cruiser0002/laserresin5/export/SM5B_3_ASM_BOM.xlsx

Photonbeam
Item # | Name | Part number | Quantity | Supplier
1 | platform | SM01B | 1 | Metalfx
2 | crane | SM02B | 1 | Metalfx
3 | drawer | SM03B | 1 | Metalfx
4 | drawer_pcb | SM04B | 1 | Metalfx
5 | frame_front | SM05B | 1 | Metalfx
6 | reservoir | SM06B | 2 | Metalfx
7 | foot | SM07B | 1 | Metalfx
8 | frame_back | SM08B | 1 | Metalfx
9 | laserholder | SM09B | 1 | Metalfx
 | tray |  | 1 | Ponoko
 | shield_front |  | 1 | Ponoko
 | shield_side |  | 2 | Ponoko
 | shield_top |  | 1 | Ponoko
Mechanical
Item # | Name | Part # | Quantity | Supplier | Link
1 | ACME 8mm 250mm (pitch = ?) |  | 1 | ebay
2 | LMK8LUU | LMK8LUU | 2 | ebay
3 | SHF8 | SHF8 | 4 | ebay
4 | NEMA17 |  | 1 | ebay
5 | Handles | 91251A106 | 2 | mcmaster | http://www.mcmaster.com/#1568a63/=14mm5we
Mounting hardware
Item # | Name | Part # | Quantity | Supplier | Link
1 | M3 press fit nut | s-m3-0 | 24 | ebay | http://www.ebay.com/itm/200-Pieces-S-M3-0-Steel-Self-Clinching-Nut-Galvanized-/331943960998
2 | M5 press fit nut | s-m5-1 | 8 | ebay | http://www.ebay.com/itm/150-Pieces-S-M5-1-Steel-Self-Clinching-Nut-Galvanized-/232052049197
3 | M3x5 screw | 91239A110 | 12 | mcmaster | http://www.mcmaster.com/#91239a110/=14mmbfn
4 | M3x10 screw | 91239A115 | 57 | mcmaster | http://www.mcmaster.com/#91239a115/=14mmbom
5 | M3 thumb screw | 92552A418 | 1 | mcmaster | http://www.mcmaster.com/#92552a418/=14mmo47
6 | M5x16 screw | 91239A232 | 8 | mcmaster | http://www.mcmaster.com/#91239a232/=14mmc0l
7 | M5 thumb screw | 96016A233 | 8 | mcmaster | http://www.mcmaster.com/#96016a233/=14mmegs
8 | 4-40 screw | 91251A106 | 4 | mcmaster | http://www.mcmaster.com/#91251a106/=14mmd2q
9 | M4x6 screw | 91239A138 | 2 | mcmaster | http://www.mcmaster.com/#91239a138/=14mmfda
10 | Rivet1 | 97517A020 | 60 | mcmaster | http://www.mcmaster.com/#97517a020/=14mm0ah
11 | Rivet2 | 97526A120 | 4 | mcmaster | http://www.mcmaster.com/#97526a120/=14mlyy8
12 | M3 nut | 90591A250 | 44 | mcmaster | http://www.mcmaster.com/#90591a250/=14mmijd
13 | M5 nut | 90591A260 | 8 | mcmaster | http://www.mcmaster.com/#90591a260/=14mmi83
14 | #6 washer | 99604A101 | 32 | mcmaster | http://www.mcmaster.com/#99604a101/=14mn2r7
15 | M3 washer | 91100A120 | 32 | mcmaster | http://www.mcmaster.com/#91100a120/=14mn5js
16 | Zip tie |  | 2
Platform assembly
Item # | Name | Comment | Quantity
1 | Rivet2 | 0.126in | 4
2 | M5 press fit nut |  | 4
3 | M5 Thumb Screw |  | 4
Crane assembly
Item # | Name | Comment | Quantity
1 | M3 press fit nut |  | 8
2 | M3x5 screw | motor | 4
3 | M3x5 screw | bearing | 8
4 | M3x10 screw | endstop | 2
5 | M3 nut | endstop | 2
Drawer assembly
Item # | Name | Comment | Quantity
1 | Rivet1 | 0.072in | 8
2 | M3 press fit nut |  | 1
3 | M5 press fit nut |  | 2
4 | M3x10 screw | blank | 1
5 | M3x10 screw | safety | 2
6 | M3 nut | endstop and safety | 3
7 | M3x10 screw | to frame | 4
Drawer_PCB assembly
Item # | Name | Comment | Quantity
1 | Rivet1 | 0.072in | 8
2 | M3 press fit nut |  | 1
3 | M5 press fit nut |  | 2
4 | M3 thumb screw | endstop | 1
5 | M3x10 screw | safety | 2
6 | M3 nut | endstop and safety | 3
7 | M3x10 screw | to frame | 4
Frame_front assembly
Item # | Name | Comment | Quantity
1 | Rivet1 | 0.072in | 8
2 | M3 press fit nut |  | 6
3 | M3x10 screw | acme | 4
4 | M5x16 screw | shf8 | 8
5 | M5 nut | shf8 | 8
6 | M3 nut | acme | 4
Reservoir assembly
Item # | Name | Comment | Quantity
1 | M3x10 screw | tray | 32
2 | 4-40 screw | handle | 4
3 | M5 thumb screw |  | 4
4 | #6 washer | seal | 32
5 | M3 nut | tray | 32
6 | M3 washer | tray | 32
Foot assembly
Item # | Name | Comment | Quantity
1 | M3x10 screw | to frame | 4
Frame_back assembly
Item # | Name | Comment | Quantity
1 | Rivet1 | 0.072in | 8
2 | Rivet1 | 0.072in | 28
3 | M3 press fit nut |  | 8
4 | M4x6 screw | galvo | 2
Laserholder assembly
Item # | Name | Comment | Quantity
1 | M3x10 screw | to frame | 2
2 | Zip tie | laser | 2
