cruiser0002/laserresin5/export/SM5B_3_BOM.xlsx

 |  |  |  |  |  |  | 2D raw material dimensions |  | 2D raw material dimensions
Item # | Name | Quantity | Part number | Revision | Material | Thickness | X dimension (mm) | Y dimension (mm) | X dimension (in) | Y dimension (in) | Finish | Color | Welding
1 | platform | 1 | SM01B | 2.1.1 | Aluminum | 0.063 | 144.48 | 234.48 | 5.688 | 9.231 | None | None | None
2 | crane | 1 | SM02B | 2.1.1 | Aluminum | 0.063 | 234 | 144.48 | 9.213 | 5.688 | Powder coat | C241-BL210 | None
3 | drawer | 1 | SM03B | 2.1.1 | Steel | 20 GA | 344.85 | 379.83 | 13.577 | 14.954 | Powder coat | C241-BL210 | None
4 | drawer_pcb | 1 | SM04B | 2.1.1 | Steel | 20 GA | 344.85 | 379.83 | 13.577 | 14.954 | Powder coat | C241-BL210 | None
5 | frame_front | 1 | SM05B | 2.1.1 | Steel | 20 GA | 387.01 | 607.01 | 15.237 | 23.898 | Powder coat | C241-BL210 | None
6 | reservoir | 2 | SM06B | 2.1.1 | Stainless Steel | 20 GA | 217.24 | 256.07 | 8.553 | 10.081 | None | None | Watertight seam, grind outside flat
7 | foot | 1 | SM07B | 2.1.1 | Steel | 20 GA | 230.31 | 196 | 9.067 | 7.717 | Powder coat | C241-BL210 | None
8 | frame_back | 1 | SM08B | 2.1.1 | Steel | 20 GA | 382.76 | 602.76 | 15.069 | 23.731 | Powder coat | C241-BL210 | None
9 | laserholder | 1 | SM09B | 2.1.1 | Steel | 20 GA | 30 | 85.22 | 1.181 | 3.355 | Powder coat | C241-BL210 | None
