cruiser0002/laserresin5/export/SM5B_BOM.xlsx

 |  |  |  |  |  |  | 2D raw material dimensions |  | 2D raw material dimensions
Item # | Name | Quantity | Part number | Revision | Material | Thickness | X dimension (mm) | Y dimension (mm) | X dimension (in) | Y dimension (in) | Finish | Color | Welding | material (sqin) | paint area (sqin) | cut length (in) | folds
1 | platform | 1 | SM01B | 2.0 | Aluminum | 0.063 | 144.48 | 234.48 | 5.688 | 9.231 | None | None | None | 52.51049414 | 80 | 65.00 | 12
2 | crane | 1 | SM02B | 2.0 | Aluminum | 0.063 | 234 | 144.48 | 9.213 | 5.688 | Powder coat | C241-BL210 | None | 52.40300081 | 104 | 46.00 | 2
3 | drawer | 1 | SM03B | 2.0.1 | Aluminum | 0.032 | 345.26 | 399.24 | 13.593 | 15.718 | Powder coat | C241-BL210 | None | 213.654911 | 322 | 92.00 | 10
4 | drawer_pcb | 1 | SM04B | 2.0.1 | Aluminum | 0.032 | 345.26 | 399.24 | 13.593 | 15.718 | Powder coat | C241-BL210 | None | 213.654911 | 320 | 97.00 | 10
5 | frame_front | 1 | SM05B | 2.0.1 | Steel | 20 GA | 387.24 | 607.01 | 15.246 | 23.898 | Powder coat | C241-BL210 | None | 364.3414849 | 492 | 176.00 | 12
6 | reservoir | 2 | SM06B | 2.0 | Stainless Steel | 20 GA | 217.24 | 256.07 | 8.553 | 10.081 | None | None | Watertight seam, grind outside flat | 86.22457499 | 106 | 73.00 | 6
7 | foot | 1 | SM07B | 2.0.1 | Aluminum | 0.063 | 225.62 | 196 | 8.883 | 7.717 | Powder coat | C241-BL210 | None | 68.54349309 | 139 | 35.00 | 6
8 | frame_back | 1 | SM08B | 2.0.1 | Steel | 20 GA | 383 | 602.76 | 15.079 | 23.731 | Powder coat | C241-BL210 | None | 357.8291897 | 437 | 168.00 | 8
9 | laserholder | 1 | SM09B | 2.0 | Aluminum | 0.063 | 30 | 85.22 | 1.181 | 3.355 | None | None | None | 3.962737925 | 8 | 13.00 | 3
 | Material | Thickness | 4x10 sheet | per sqin |  | Material | Thickness | per fold
 | Aluminum | 0.063 | 76.8 | 0.01333333333 |  | Aluminum | 0.063 | 0.64
 | Aluminum | 0.032 | 33.15 | 0.005755208333 |  | Aluminum | 0.032 | 0.64
 | Steel | 20 GA | 29.1 | 0.005052083333 |  | Steel | 20 GA | 0.64
 | Stainless Steel | 20 GA | 62 | 0.01076388889 |  | Stainless Steel | 20 GA | 0.64
 |  |  | 2k max laser |  |  |  |  | paint cost
 | Material | Thickness | cutting rate 2 (in/min) | cost |  | Material | Thickness | per sqin
 | Aluminum | 0.063 | 170 | 0.1 |  | Aluminum | 0.063 | 0.034
 | Aluminum | 0.032 | 260 | 0.026 |  | Aluminum | 0.032 | 0.034
 | Steel | 20 GA | 214 | 0.07 |  | Steel | 20 GA | 0.012
 | Stainless Steel | 20 GA | 220 | 0.26 |  | Stainless Steel | 20 GA | 0.012
Item # | Name | Quantity | Part number | 1000x | 1k no paint | 100x | 4x
1 | platform | 1 | SM01B | 10.37 |  | 11.37 | 62.5
2 | crane | 1 | SM02B | 10.07 | 6.51 | 11.08 | 62.5
3 | drawer | 1 | SM03B | 18.51 |  | 19.99 | 72.95
4 | drawer_pcb | 1 | SM04B | 18.51 |  | 19.99 | 72.95
5 | frame_front | 1 | SM05B | 25 | 19.06 | 26.78 | 88.06
6 | reservoir | 2 | SM06B | 22.77 |  | 22.98 | 42.84
7 | foot | 1 | SM07B | 10.95 |  | 12.14 | 63.92
8 | frame_back | 1 | SM08B | 20.68 | 14.74 | 22.46 | 83.74
9 | laserholder | 1 | SM09B | 5.84 |  | 6.59 | 62.5
 |  |  |  | 142.7
Item # | Name | Quantity | Part number | Material | Thickness | cut length (in) | cutting time (min)
1 | platform | 1 | SM01B | Aluminum | 0.063 | 29.84 | 0.18
2 | crane | 1 | SM02B | Aluminum | 0.063 | 29.80 | 0.18
3 | drawer | 1 | SM03B | Aluminum | 0.032 | 58.62 | 0.23
4 | drawer_pcb | 1 | SM04B | Aluminum | 0.032 | 58.62 | 0.23
5 | frame_front | 1 | SM05B | Steel | 20 GA | 78.29 | 0.37
6 | reservoir | 2 | SM06B | Stainless Steel | 20 GA | 37.27 | 0.17
7 | foot | 1 | SM07B | Aluminum | 0.063 | 33.20 | 0.20
8 | frame_back | 1 | SM08B | Steel | 20 GA | 77.62 | 0.36
9 | laserholder | 1 | SM09B | Aluminum | 0.063 | 9.07 | 0.05
 |  |  |  |  |  |  | 1.95
Item # | Name | Quantity | Part number | Material | Thickness | 1000x | effective folds | fold cost | remainder
1 | platform | 1 | SM01B | Aluminum | 0.063 | 10.37 | 8 | 5.12 | 5.25
2 | crane | 1 | SM02B | Aluminum | 0.063 | 10.07 | 2 | 1.28 | 8.79
3 | drawer | 1 | SM03B | Aluminum | 0.032 | 18.51 | 8 | 5.12 | 13.39
4 | drawer_pcb | 1 | SM04B | Aluminum | 0.032 | 18.51 | 8 | 5.12 | 13.39
5 | frame_front | 1 | SM05B | Steel | 20 GA | 25 | 10 | 6.4 | 18.6
6 | reservoir | 2 | SM06B | Stainless Steel | 20 GA | 22.77 | 6 | 3.84 | 18.93
7 | foot | 1 | SM07B | Aluminum | 0.063 | 10.95 | 6 | 3.84 | 7.11
8 | frame_back | 1 | SM08B | Steel | 20 GA | 20.68 | 8 | 5.12 | 15.56
9 | laserholder | 1 | SM09B | Aluminum | 0.063 | 5.84 | 3 | 1.92 | 3.92
Item # | Name | Quantity | Part number | Material | 1000x | 1k no paint | paint area (sqin) |  | paint cost | remainder
1 | platform | 1 | SM01B | Aluminum | 10.37 |  | 80 |  | 2.72 | 7.65
2 | crane | 1 | SM02B | Aluminum | 10.07 | 6.51 | 104 | 0.03423076923 | 3.54 | 6.53
3 | drawer | 1 | SM03B | Aluminum | 18.51 |  | 322 |  | 10.95 | 7.56
4 | drawer_pcb | 1 | SM04B | Aluminum | 18.51 |  | 320 |  | 10.88 | 7.63
5 | frame_front | 1 | SM05B | Steel | 25 | 19.06 | 492 | 0.01207317073 | 5.90 | 19.10
6 | reservoir | 2 | SM06B | Stainless Steel | 22.77 |  | 106 |  |  | 22.77
7 | foot | 1 | SM07B | Aluminum | 10.95 |  | 139 |  | 4.73 | 6.22
8 | frame_back | 1 | SM08B | Steel | 20.68 | 14.74 | 437 | 0.01359267735 | 5.24 | 15.44
9 | laserholder | 1 | SM09B | Aluminum | 5.84 |  | 8 |  | 0.27 | 5.57
Item # | Name | Quantity | Part number | Material | Thickness | 1000x | material (sqin) | material cost
1 | platform | 1 | SM01B | Aluminum | 0.063 | 10.37 | 52.51049414 | 0.70
2 | crane | 1 | SM02B | Aluminum | 0.063 | 10.07 | 52.40300081 | 0.70
3 | drawer | 1 | SM03B | Aluminum | 0.032 | 18.51 | 213.654911 | 1.23
4 | drawer_pcb | 1 | SM04B | Aluminum | 0.032 | 18.51 | 213.654911 | 1.23
5 | frame_front | 1 | SM05B | Steel | 20 GA | 25 | 364.3414849 | 1.84
6 | reservoir | 2 | SM06B | Stainless Steel | 20 GA | 22.77 | 86.22457499 | 0.93
7 | foot | 1 | SM07B | Aluminum | 0.063 | 10.95 | 68.54349309 | 0.91
8 | frame_back | 1 | SM08B | Steel | 20 GA | 20.68 | 357.8291897 | 1.81
9 | laserholder | 1 | SM09B | Aluminum | 0.063 | 5.84 | 3.962737925 | 0.05
Item # | Name | Quantity | Part number | Material | Thickness | 1000x | paint cost | remainder | fold cost | remainder | material cost | remainder | cut length (in) | cutting cost (per in) | cutting speed
1 | platform | 1 | SM01B | Aluminum | 0.063 | 10.37 |  | 10.37 | 5.12 | 5.25 | 0.70 | 4.55 | 65.00 | 0.08076923077 | 14.28615361
2 | crane | 1 | SM02B | Aluminum | 0.063 | 10.07 | 3.54 | 6.53 | 1.28 | 5.25 | 0.70 | 4.56 | 46.00 | 0.1142173913 | 10.09814226
3 | drawer | 1 | SM03B | Aluminum | 0.032 | 18.51 | 10.95 | 7.56 | 5.12 | 2.44 | 1.23 | 1.21 | 92.00 | 0.02654347826 | 75.88433236
4 | drawer_pcb | 1 | SM04B | Aluminum | 0.032 | 18.51 | 10.88 | 7.63 | 5.12 | 2.51 | 1.23 | 1.28 | 97.00 | 0.02587628866 | 75.7592635
5 | frame_front | 1 | SM05B | Steel | 20 GA | 25 | 5.90 | 19.10 | 6.4 | 12.70 | 1.84 | 10.86 | 176.00 | 0.07213636364 | 16.21325373
6 | reservoir | 2 | SM06B | Stainless Steel | 20 GA | 22.77 |  | 22.77 | 3.84 | 18.93 | 0.93 | 18.00 | 73.00 | 0.2593150685 | 4.05513016
7 | foot | 1 | SM07B | Aluminum | 0.063 | 10.95 | 4.73 | 6.22 | 3.84 | 2.38 | 0.91 | 1.47 | 35.00 | 0.06811428571 | 23.80811866
8 | frame_back | 1 | SM08B | Steel | 20 GA | 20.68 | 5.24 | 15.44 | 5.12 | 10.32 | 1.81 | 8.51 | 168.00 | 0.0614047619 | 19.74561741
9 | laserholder | 1 | SM09B | Aluminum | 0.063 | 5.84 |  | 5.84 | 1.92 | 3.92 | 0.05 | 3.87 | 13.00 | 0.3015384615 | 3.361637029
 |  |  |  |  |  | 142.70 | 41.24 | 101.46 | 37.76 | 63.70 | 9.40 | 54.30
Item # | Name | Quantity | Part number | Material | Thickness | paint area (sqin) | paint cost | material (sqin) | material cost | effective folds | fold cost | cut length | cutting cost | sum | actual | min
1 | platform | 1 | SM01B | Aluminum | 0.063 | 0 | 0.00 | 52.51049414 | 0.70 | 8 | 5.12 | 65.00 | 6.50 | 12.32 | 10.37 | 10.37
2 | crane | 1 | SM02B | Aluminum | 0.063 | 104 | 3.54 | 52.40300081 | 0.70 | 2 | 1.28 | 46.00 | 4.60 | 10.11 | 10.07 | 10.07
3 | drawer | 1 | SM03B | Steel | 20 GA | 322 | 3.86 | 213.654911 | 1.08 | 8 | 5.12 | 92.00 | 6.44 | 16.50 | 18.51 | 16.50
4 | drawer_pcb | 1 | SM04B | Steel | 20 GA | 320 | 3.84 | 213.654911 | 1.08 | 8 | 5.12 | 97.00 | 6.79 | 16.83 | 18.51 | 16.83
5 | frame_front | 1 | SM05B | Steel | 20 GA | 492 | 5.90 | 364.3414849 | 1.84 | 10 | 6.4 | 176.00 | 12.32 | 26.46 | 25 | 25
6 | reservoir | 2 | SM06B | Stainless Steel | 20 GA | 0 | 0.00 | 86.22457499 | 0.93 | 6 | 3.84 | 73.00 | 18.98 | 23.75 | 22.77 | 22.77
7 | foot | 1 | SM07B | Steel | 20 GA | 139 | 4.73 | 68.54349309 | 0.35 | 6 | 3.84 | 35.00 | 2.45 | 11.36 | 10.95 | 10.95
8 | frame_back | 1 | SM08B | Steel | 20 GA | 437 | 5.24 | 357.8291897 | 1.81 | 8 | 5.12 | 168.00 | 11.76 | 23.93 | 20.68 | 20.68
9 | laserholder | 1 | SM09B | Steel | 20 GA | 8 | 0.10 | 3.962737925 | 0.02 | 3 | 1.92 | 13.00 | 0.91 | 2.95 | 5.84 | 5.84
 |  |  |  |  |  |  | 27.21 |  | 8.50 |  | 37.76 |  | 70.75 | 144.22 | 142.70 | 139.01
