cruiser0002/laserresin5/export/laserholder.stp

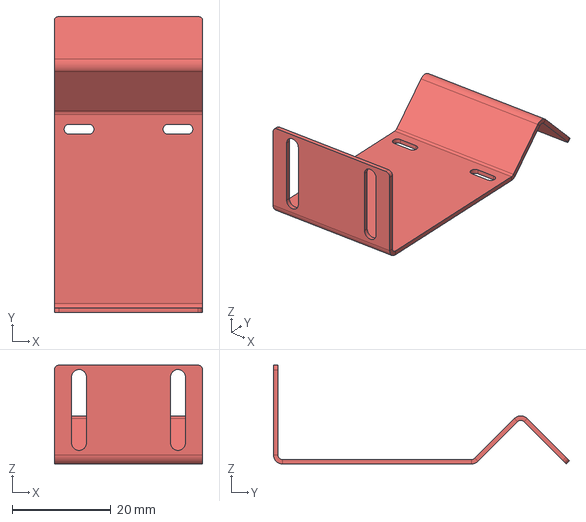
[picture p1: CAD file, 2016-10-17]
export/laserholder.stp
30.0 x 59.8 x 20.0 mm
