cruiser0002/laserresin5/export/frame_front.stp

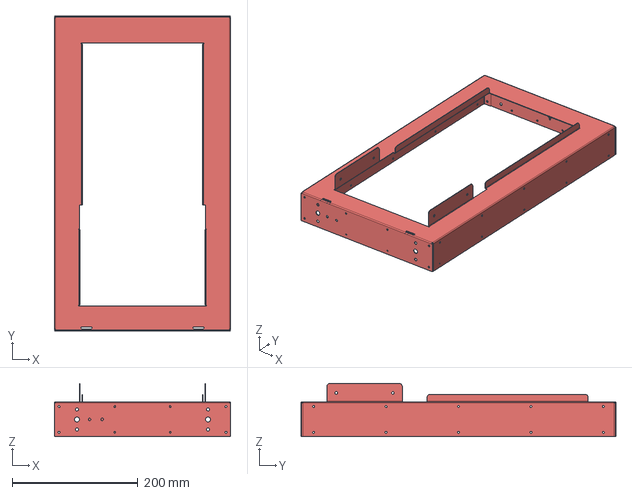
[picture p2: CAD file, 2016-10-17]
export/frame_front.stp
280.0 x 500.0 x 84.2 mm
