cruiser0002/laserresin5/export/drawer_pcb.stp

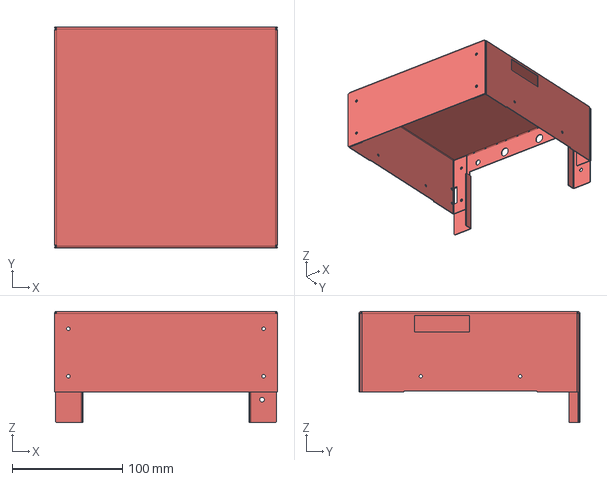
[picture p3: CAD file, 2016-10-17]
export/drawer_pcb.stp
202.0 x 200.0 x 101.0 mm
