cruiser0002/laserresin5/export/frame_back.stp

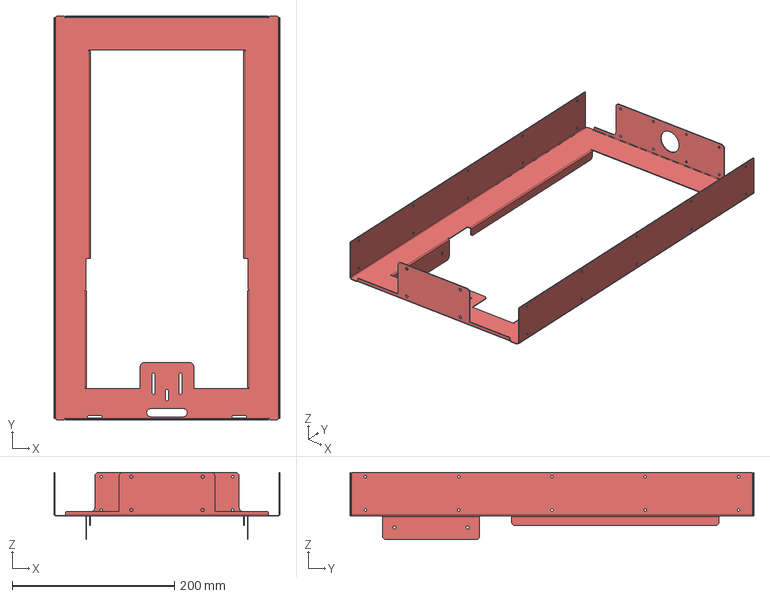
[picture p4: CAD file, 2016-10-17]
export/frame_back.stp
278.0 x 498.0 x 83.1 mm
