cruiser0002/laserresin5/export/reservoir.stp

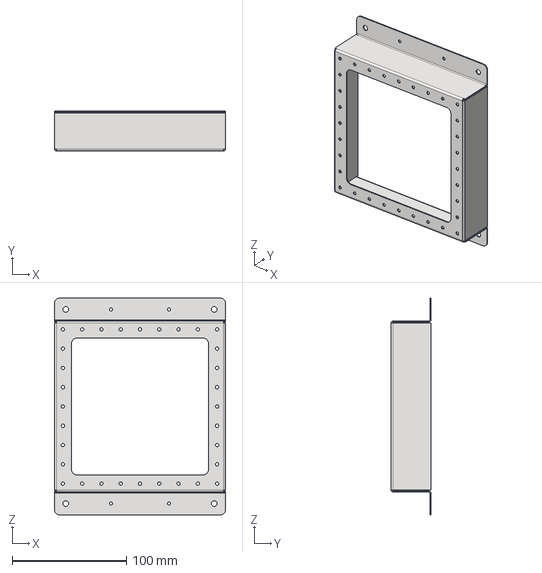
[picture p5: CAD file, 2016-10-17]
export/reservoir.stp
150.0 x 35.0 x 190.0 mm
