cruiser0002/laserresin5/export/foot.stp

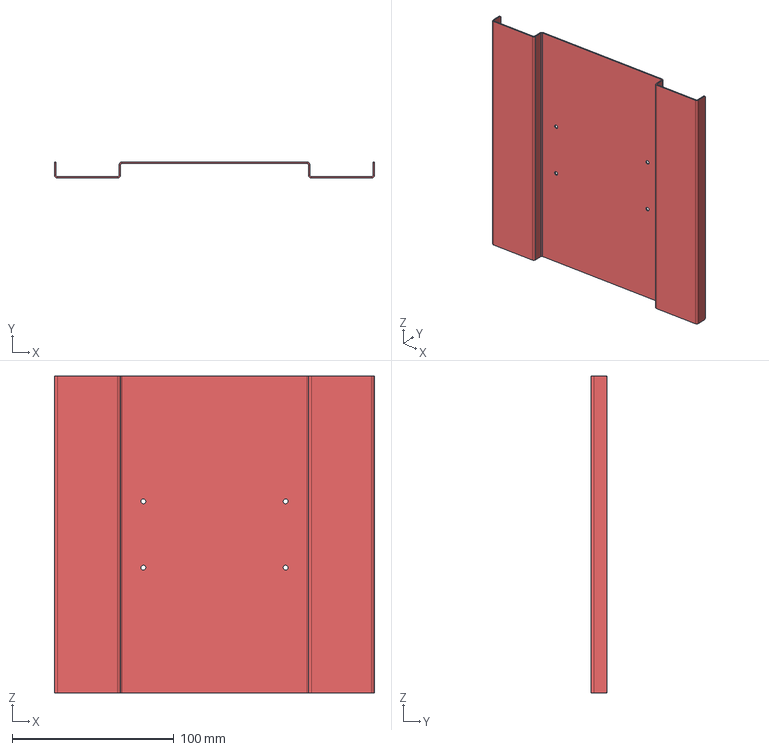
[picture p6: CAD file, 2016-10-17]
export/foot.stp
198.0 x 10.0 x 196.0 mm
