cruiser0002/laserresin5/export/platform.stp

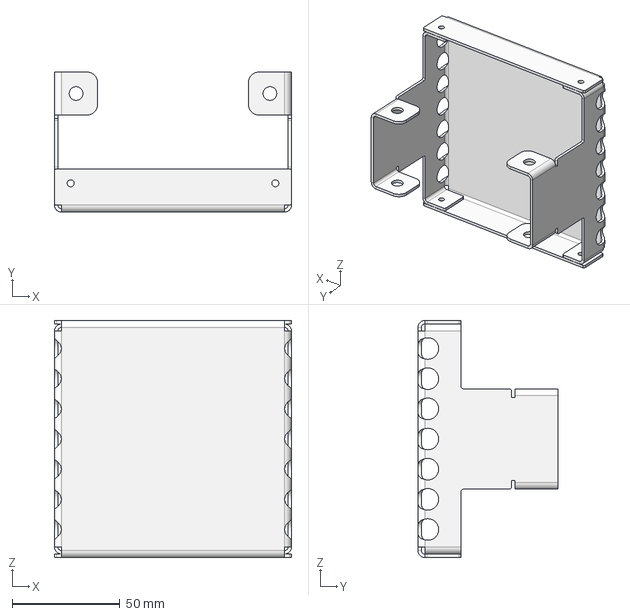
[picture p7: CAD file, 2016-10-17]
export/platform.stp
110.0 x 65.0 x 110.0 mm
