cruiser0002/laserresin5/export/crane.stp

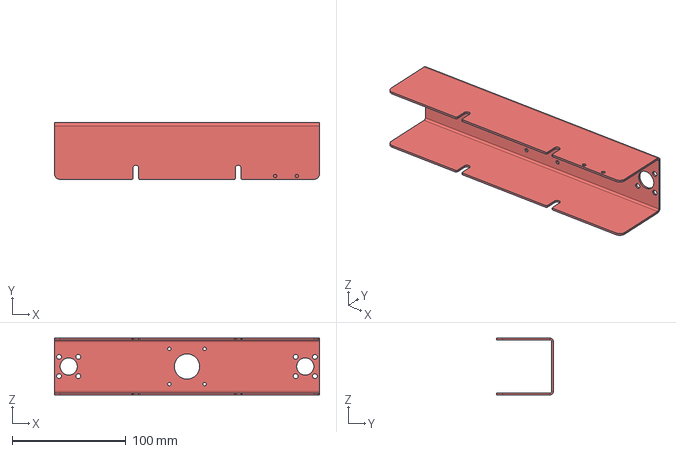
[picture p8: CAD file, 2016-10-17]
export/crane.stp
233.0 x 50.0 x 50.0 mm
