cruiser0002/laserresin5/(list of files, cad)

Other CAD files:
export/drawer.stp
crane.ipt
drawer.ipt
drawer_pcb.ipt
export/crane.dxf
export/crane.idw
export/drawer.dxf
export/drawer.idw
export/drawer_pcb.dxf
export/drawer_pcb.idw
export/foot.dxf
export/foot.idw
export/frame_back.dxf
export/frame_back.idw
export/frame_front.dxf
export/frame_front.idw
export/laserholder.dxf
export/laserholder.idw
export/platform.dxf
export/platform.idw
export/reservoir.dxf
export/reservoir.idw
features/5_16_18_tee_nut.ipt
features/ACMENUTgen.ipt
features/OldVersions/lmk8uugen.0005.ipt
features/OldVersions/nema17gen.0005.ipt
features/castlegen.ipt
features/lcdgen.ipt
features/lmk8uugen.ipt
features/nema17gen.ipt
features/shf8gen.ipt
features/tslotgen.ipt
foot.ipt
frame_back.ipt
frame_front.ipt
handle.ipt
laserholder.ipt
lmk8luu.ipt
m8_rail.ipt
nema17.ipt
platform.ipt
printer.iam
reservoir.ipt
shf8.ipt
shield.ipt
shield2.iam
shield2a.ipt
shield2b.ipt
threaded_rod.ipt
tray.ipt
