cruiser0002/laserresin5/export/reservoir.pdf

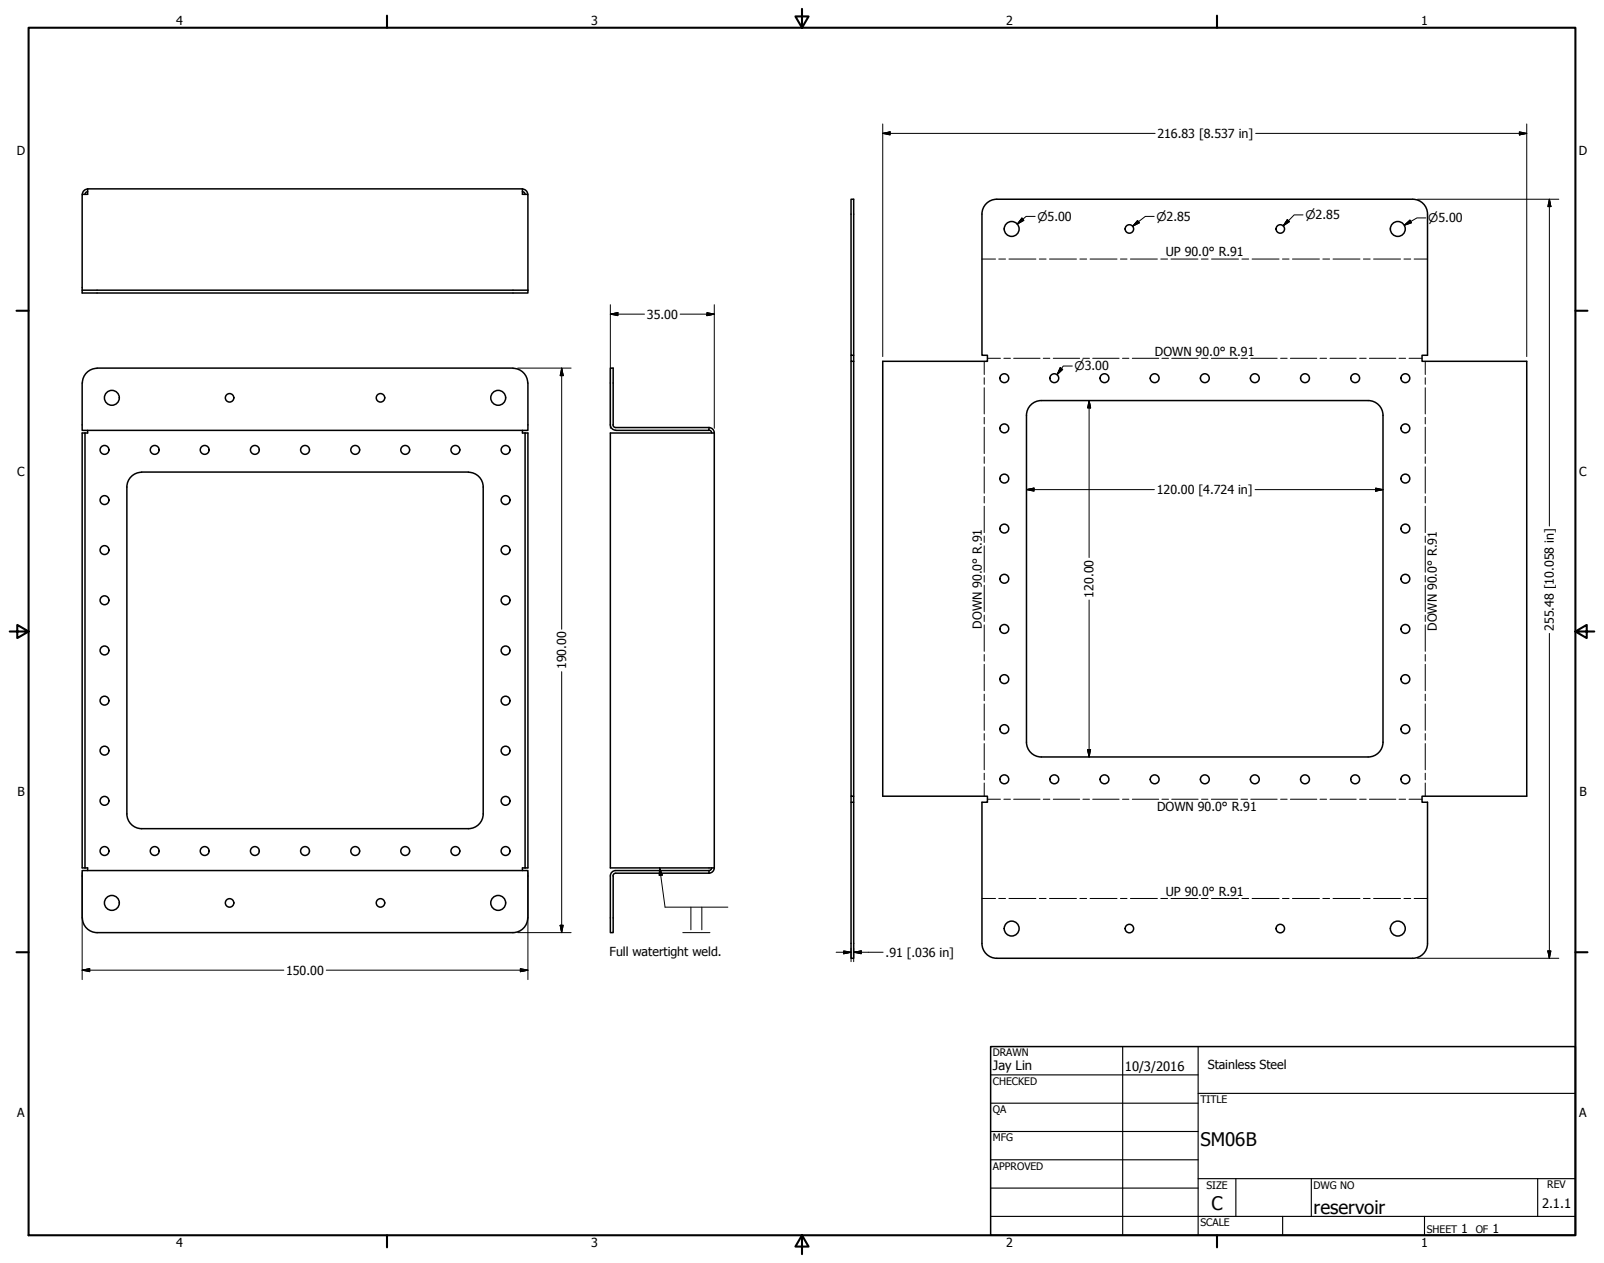
[picture p10: page 1]
SHEET 1 OF 1; DRAWN; CHECKED; MFG; APPROVED; Jay Lin; DWG NO reservoir; TITLE; SIZE C; SCALE; REV 2.1.1; DOWN 90.0° R.91; Stainless Steel

Full watertight weld.
