cruiser0002/laserresin5/export/crane.pdf

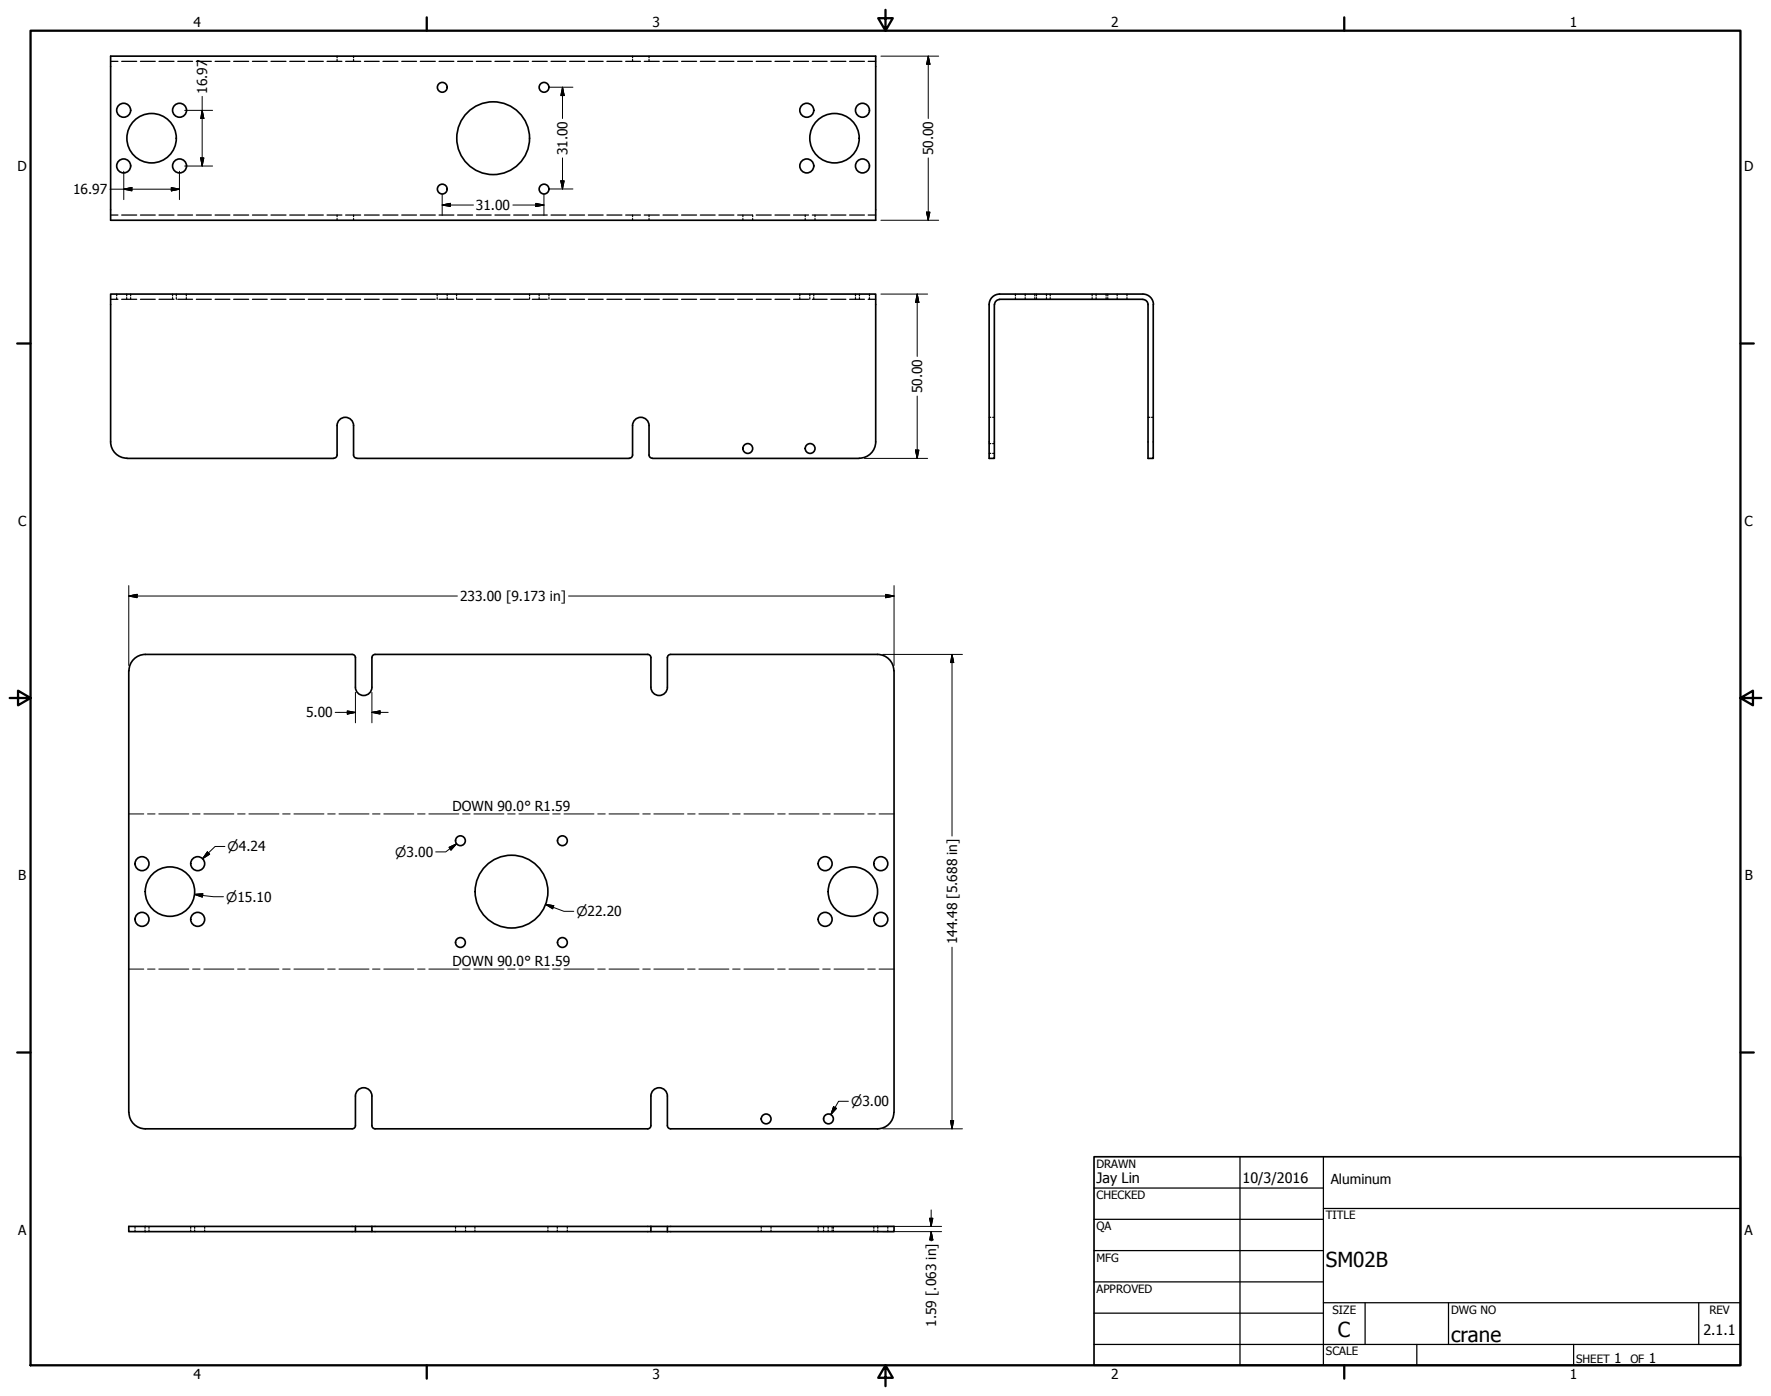
[picture p11: page 1]
SHEET 1 OF 1; DRAWN; CHECKED; MFG; APPROVED; Jay Lin; DWG NO crane; TITLE; SIZE C; SCALE; REV 2.1.1; DOWN 90.0° R1.59; Aluminum
