cruiser0002/laserresin5/export/drawer.pdf

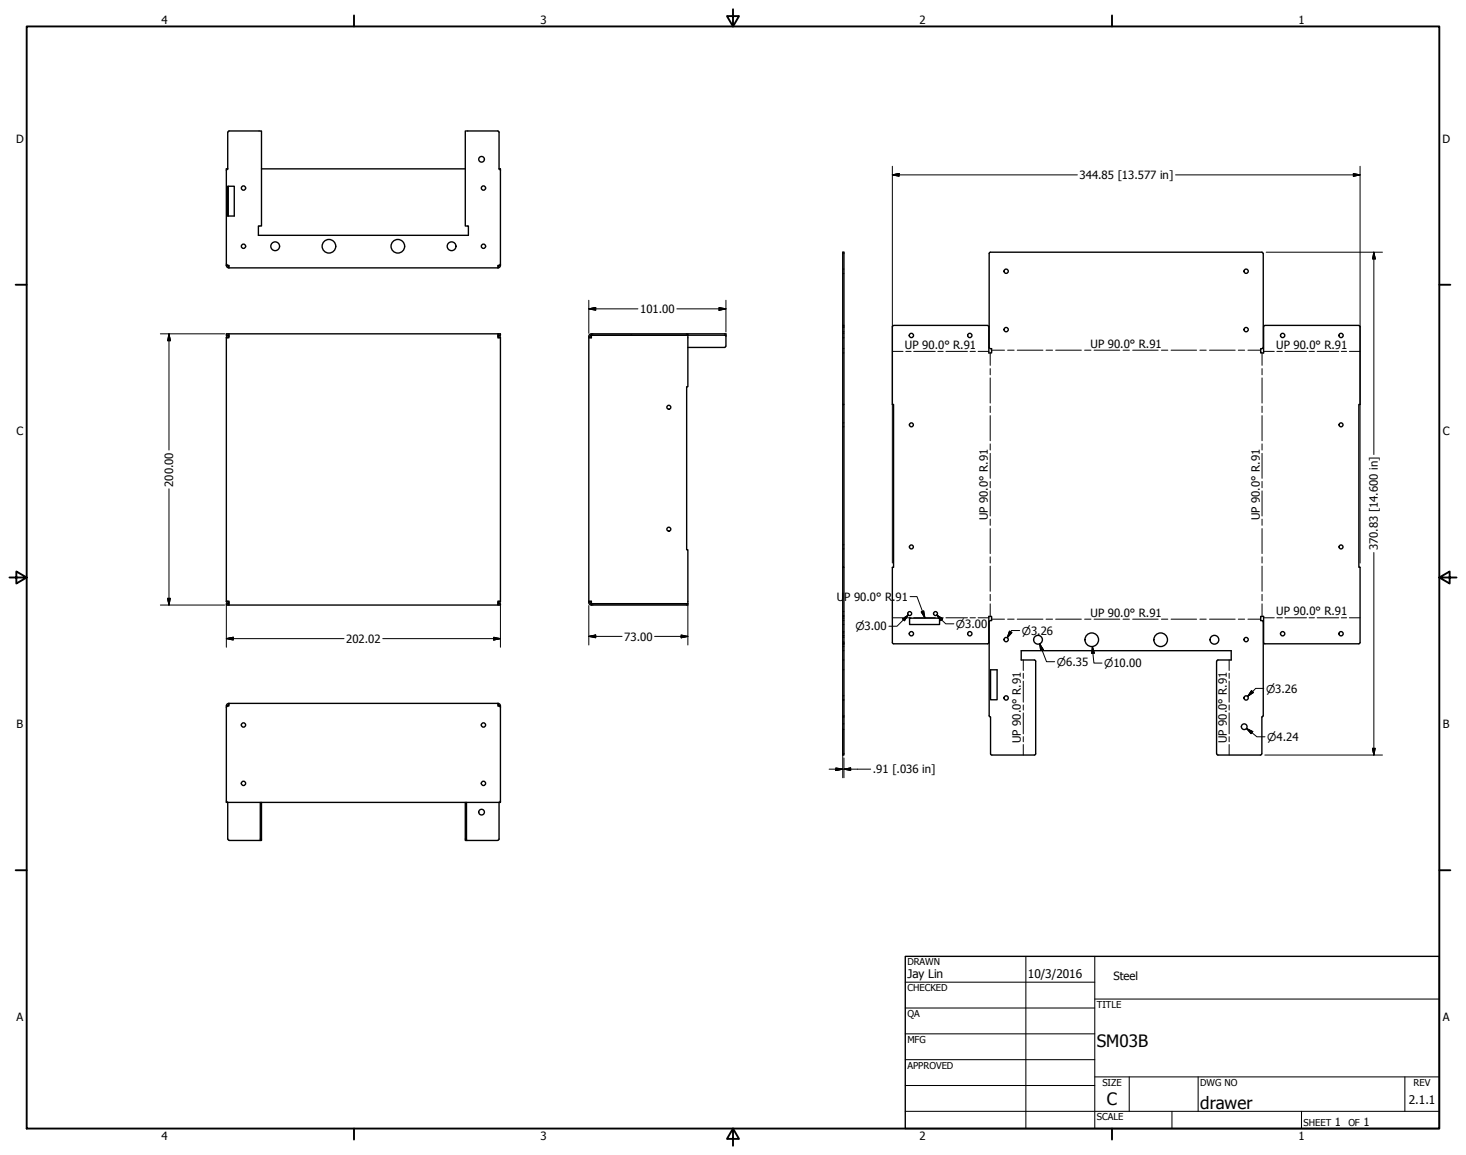
[picture p12: page 1]
SHEET 1 OF 1; DRAWN; CHECKED; MFG; APPROVED; Jay Lin; DWG NO drawer; TITLE; SIZE C; SCALE; REV 2.1.1; Steel
