cruiser0002/laserresin5/export/drawer_pcb.pdf

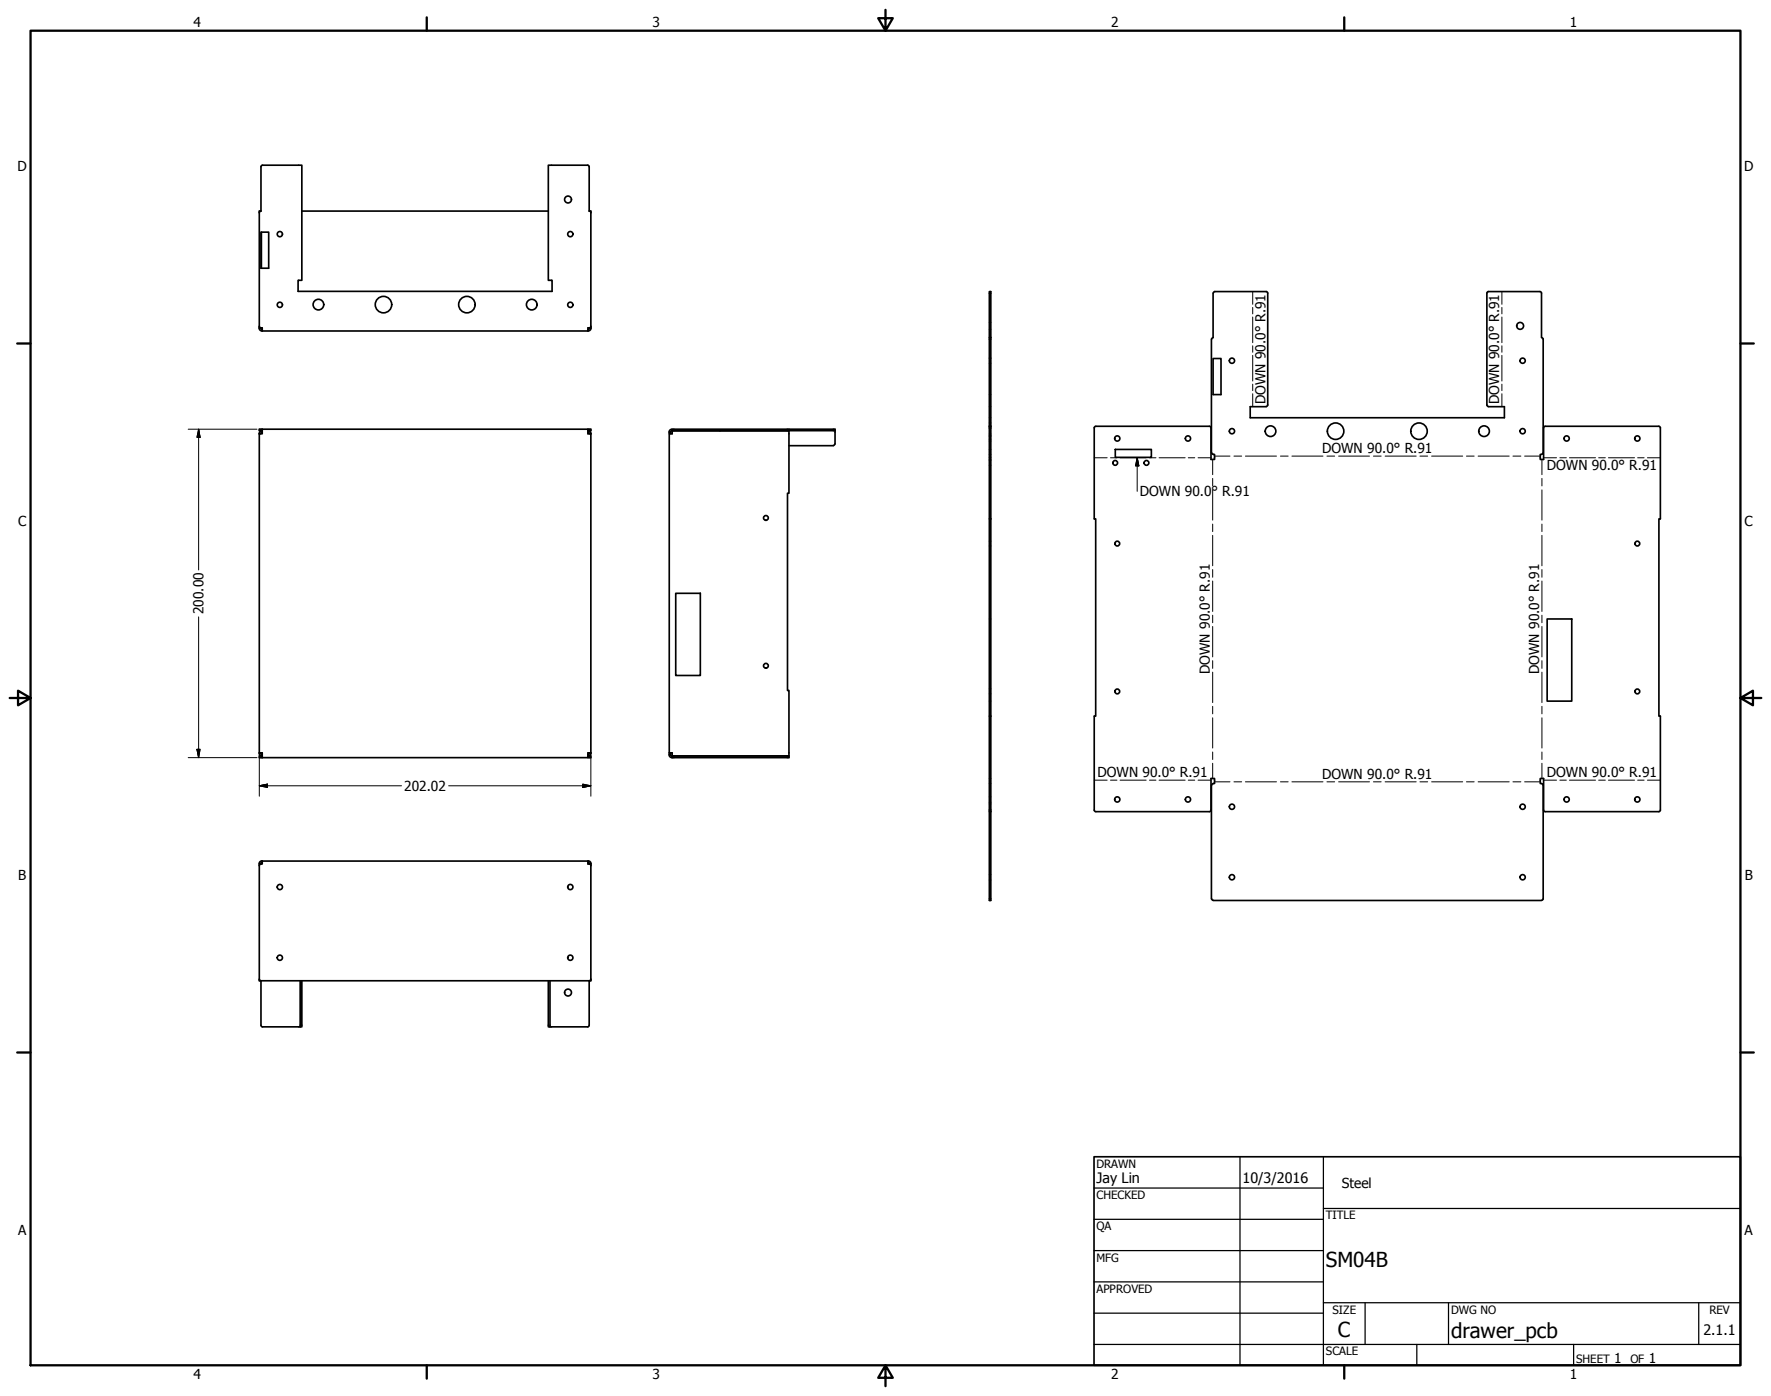
[picture p13: page 1]
SHEET 1 OF 1; DRAWN; CHECKED; MFG; APPROVED; Jay Lin; DWG NO drawer_pcb; TITLE; SIZE C; SCALE; REV 2.1.1; DOWN 90.0° R.91; Steel
