cruiser0002/laserresin5/export/foot.pdf

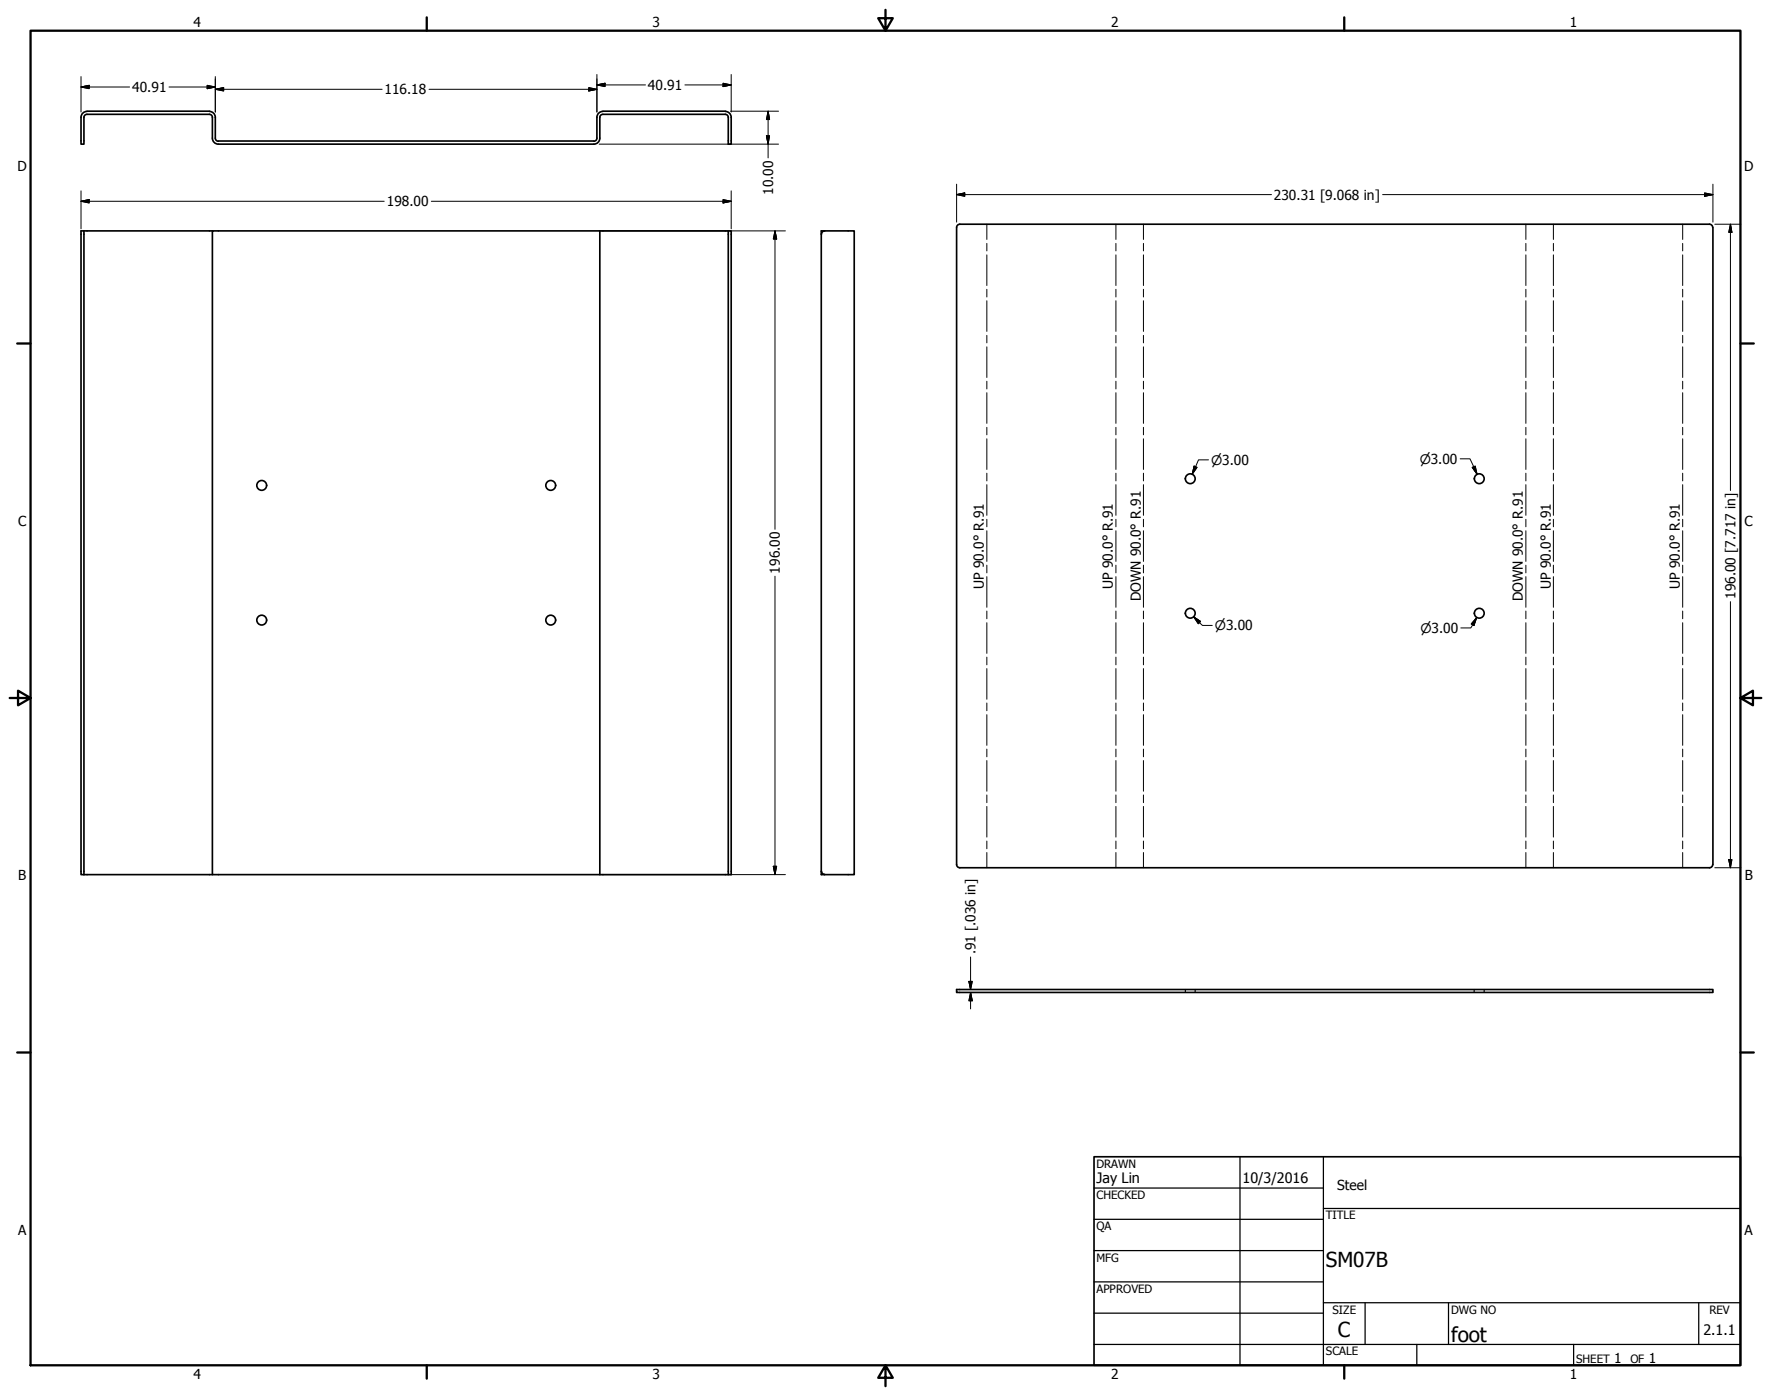
[picture p14: page 1]
SHEET 1 OF 1; DRAWN; CHECKED; MFG; APPROVED; Jay Lin; DWG NO foot; TITLE; SIZE C; SCALE; REV 2.1.1; Steel
