cruiser0002/laserresin5/export/frame_back.pdf

P

P

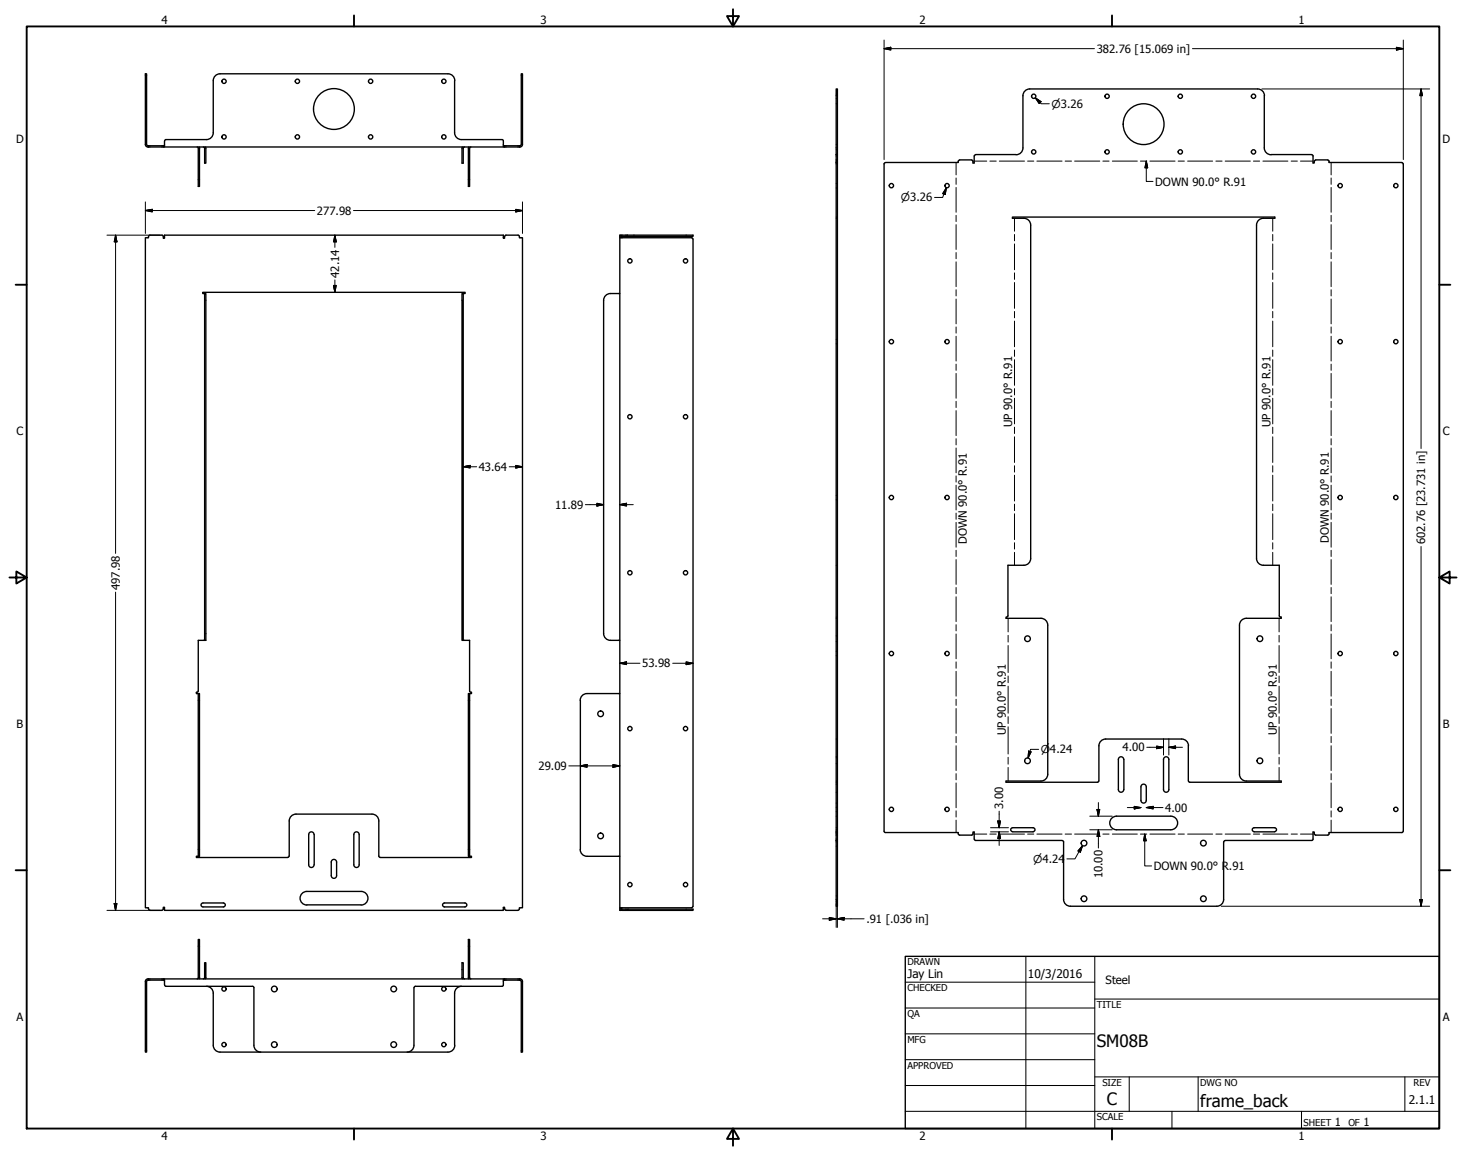
[picture p15: page 1]
DOWN 90.0° R.91
