cruiser0002/laserresin5/export/frame_front.pdf

P

P

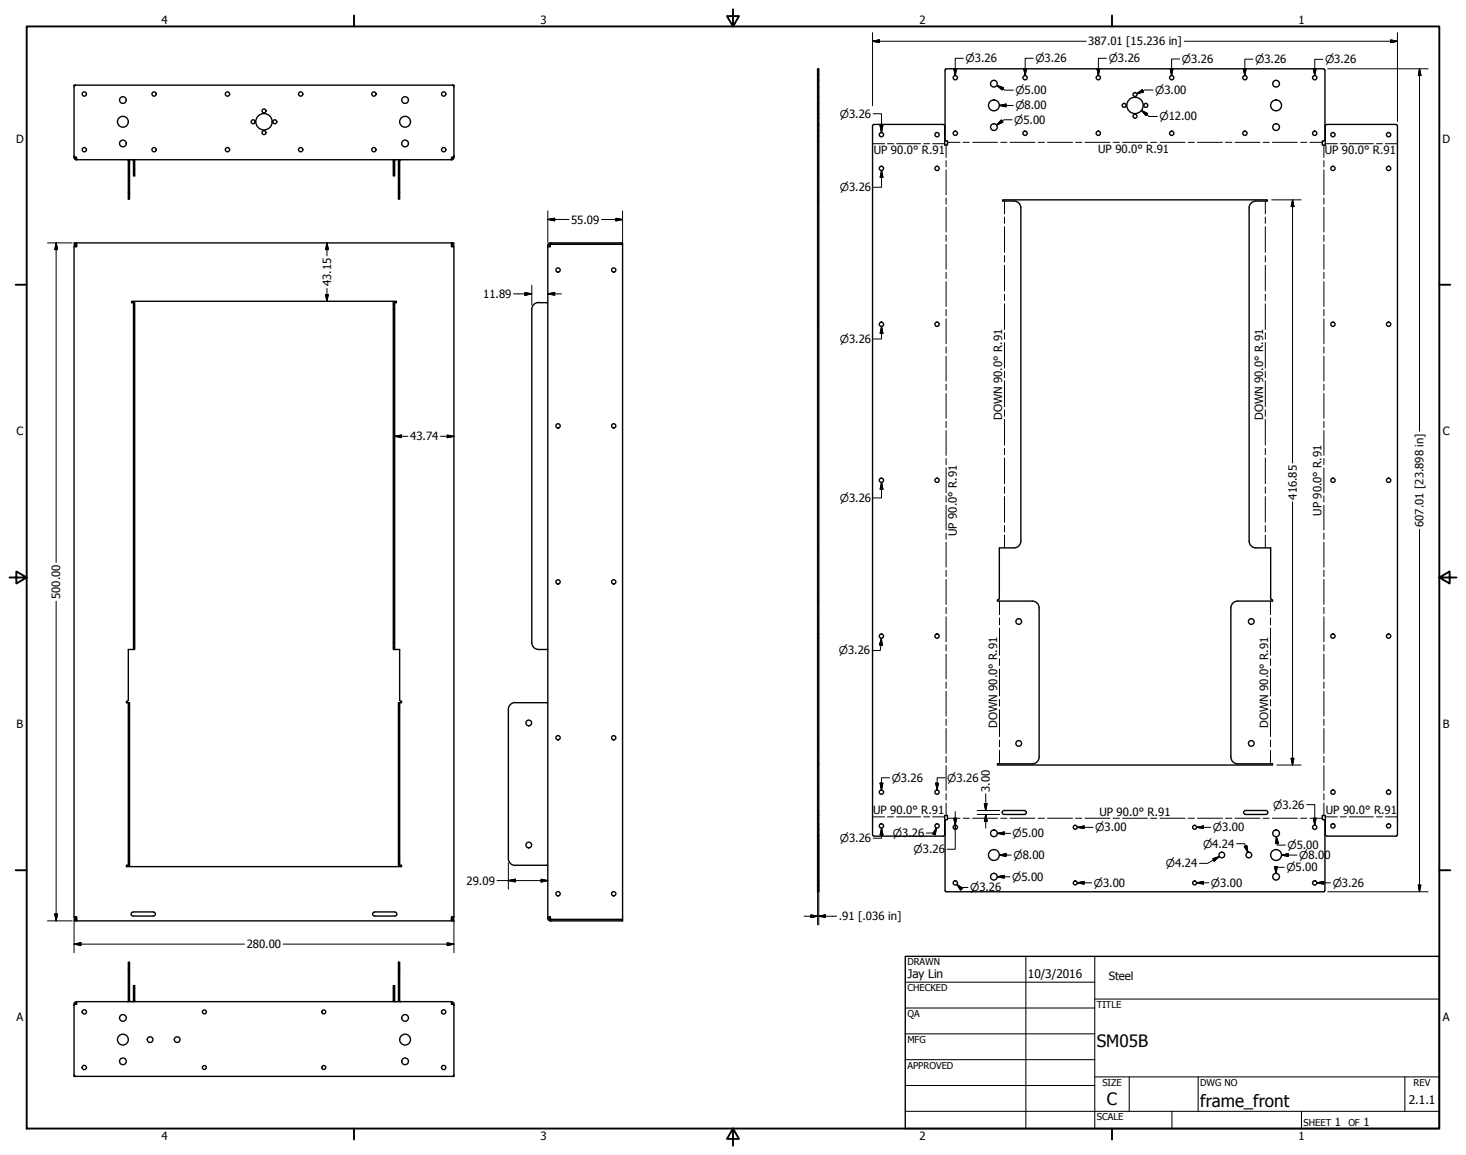
[picture p16: page 1]
DOWN 90.0° R.91
