cruiser0002/laserresin5/export/platform.pdf

P

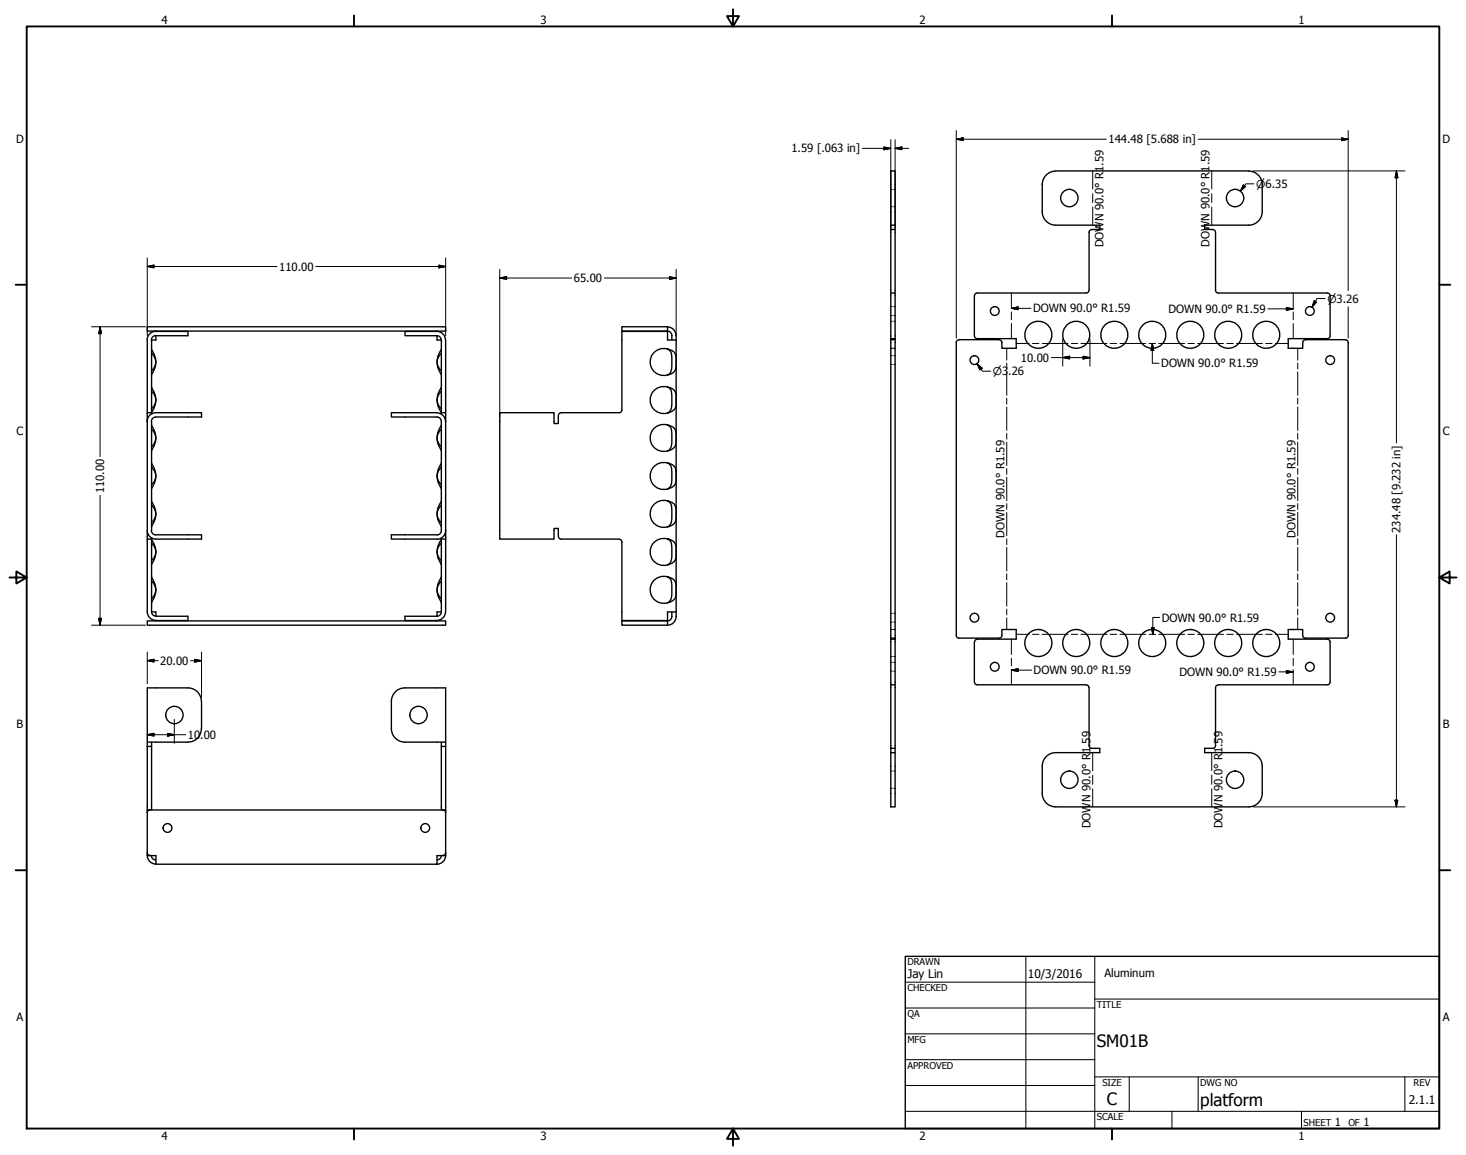
[picture p17: page 1]
pla; DOWN 90.0° R1.59; Alu
