cruiser0002/laserresin5/(commit log)

2016-09-22 Wednesday night commit
    [SM_BOM.xlsx, crane.0010.ipt, crane.ipt, drawer.0018.ipt, drawer.ipt, frame_back.0014.ipt, frame_back.ipt, frame_front.0018.ipt]
2016-10-03 RC2 edits
    [crane.ipt, drawer.ipt, drawer_pcb.ipt, foot.ipt, frame_back.ipt, frame_front.ipt, handle.ipt, laserholder.ipt]
2016-10-03 created 2d cad files
    [SMB_BOM.xlsx, crane.idw, crane.ipt, drawer.idw, drawer.ipt, drawer_pcb.idw, drawer_pcb.ipt, foot.idw]
2016-10-05 reservoir mounting holes
    [SMB_BOM.xlsx, printer.iam, reservoir.idw, reservoir.ipt]
2016-10-05 exported files
    [SMB_BOM.xlsx, crane.ipt, crane.stp, drawer.idw, drawer.ipt, drawer.stp, drawer_pcb.ipt, drawer_pcb.stp]
2016-10-05 updated tray
    [SM5B_BOM.xlsx, SMB_BOM.xlsx, SM_BOM.xlsx, crane.ipt, printer.iam, tray.ipt]
2016-10-05 add bent acrylic shield
    [crane.ipt, drawer.ipt, drawer_pcb.ipt, foot.ipt, frame_back.ipt, frame_front.ipt, handle.ipt, laserholder.ipt]
2016-10-15 v2.1 quote
    converted most materials to steel
    [SM5B_3_BOM.xlsx, SM5B_BOM.xlsx, crane.dxf, crane.idw, crane.ipt, drawer.dxf, drawer.idw, drawer.ipt]
2016-10-17 v2.1.1 update
    hardware bom and fixes
    [SM5B_3_ASM_BOM.xlsx, SM5B_3_BOM.xlsx, crane.idw, crane.ipt, crane.stp, drawer.idw, drawer.ipt, drawer.stp]
